wyu0725/2MSPS-DAQ_CARD/README.md

# 2MSPS-DAQ_CARD   
Junbin Zhang and Yu Wang's project----2channel 2MSPS DQA CARD workspace  
datasheet,use of chips,verilog code 
ustc-fel
