wyu0725/2MSPS-DAQ_CARD/Notes/EP4CE10_FIFO使用说明.docx

FIFO

可配置大小

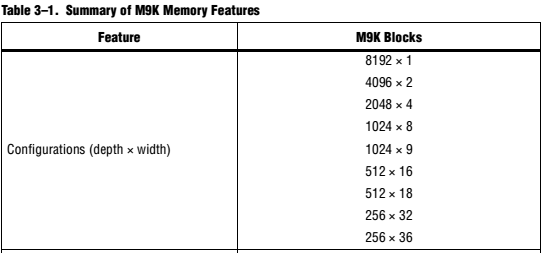
[picture p16: figure]

Cyclone IV devices M9K memory blocks do not support simultaneous read and write from an empty FIFO buffer.

SCFIFO and DCFIFO Functional Timing Requirements

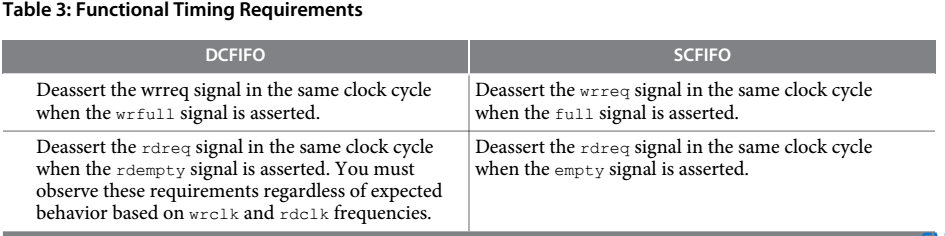
[picture p17: figure]
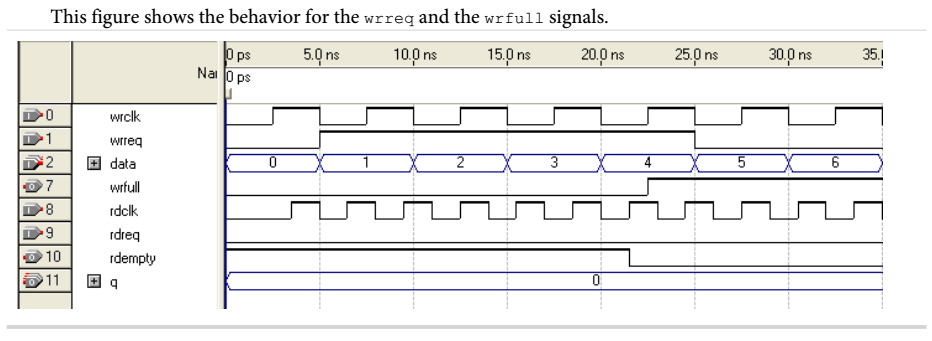
[picture p18: figure]
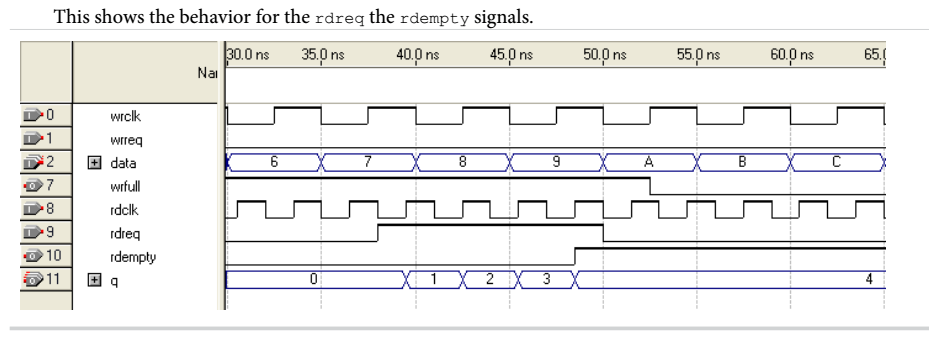
[picture p19: figure]
