wyu0725/2MSPS-DAQ_CARD/Notes/EP4CE10CLOCK&CLB&PLL.docx

CLOCK INFORMATION

EP4CE10 devices only support three dedicated clock pins on the left side and four dedicated clock pins on the right side of the device.

GCLK

1. All resources in the device (I/O elements, logic array blocks (LABs), dedicated multiplier blocks and M9K memory blocks) can use GCLKs as clock sources. Use these clock network resources for control signals, such as clock enables and clears fed by an external pin.
2. Internal logic can also drive GCLKs for internally generated GCLKs and asynchronous clears, clock enables, or other control signals with high fan-out.(?)

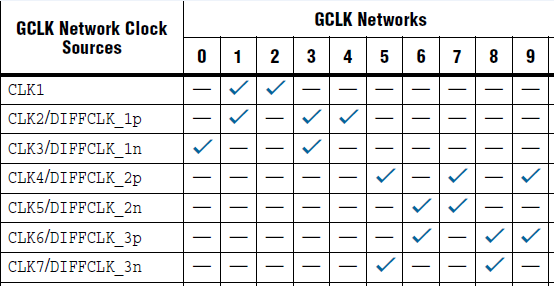
[picture p20: figure]
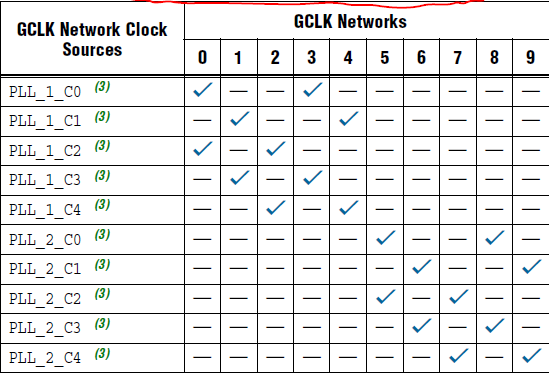
[picture p21: figure]
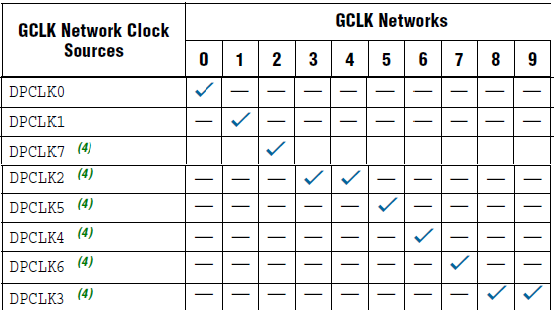
[picture p22: figure]

3. If you do not use dedicated clock pins to feed the GCLKs, you can use them as general-purpose input pins to feed the logic array. However, when using them as general-purpose input pins, they do not have support for an I/O register and must use LE-based registers in place of an I/O register.

CLOCK CONTROL BLOCK

1. The clock control block drives the GCLKs. Clock control blocks are located on each side of the device, close to the dedicated clock input pins. GCLKs are optimized for minimum clock skew and delay.
2. The sources that can feed back the clock control block

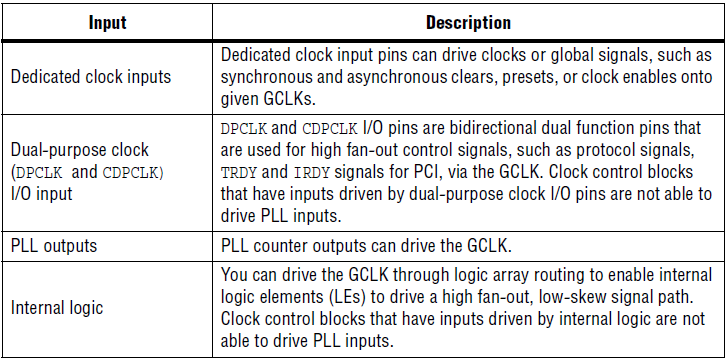
[picture p23: figure]

The output from the clock control block in turn feeds the corresponding GCLK. The GCLK can drive the PLL input if the clock control block inputs are outputs of another PLL or dedicated clock input pins.

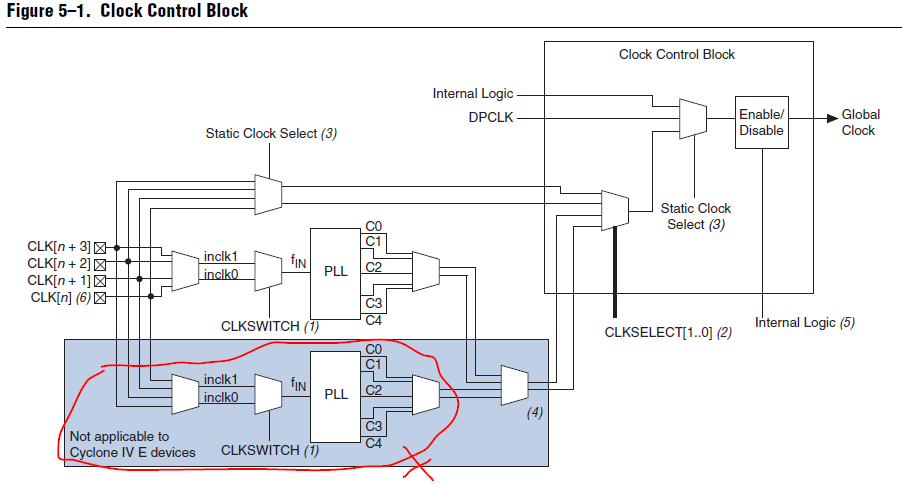
[picture p24: figure]

3. Clock Networks and Clock Control Block Locations in Cyclone IV E Devices

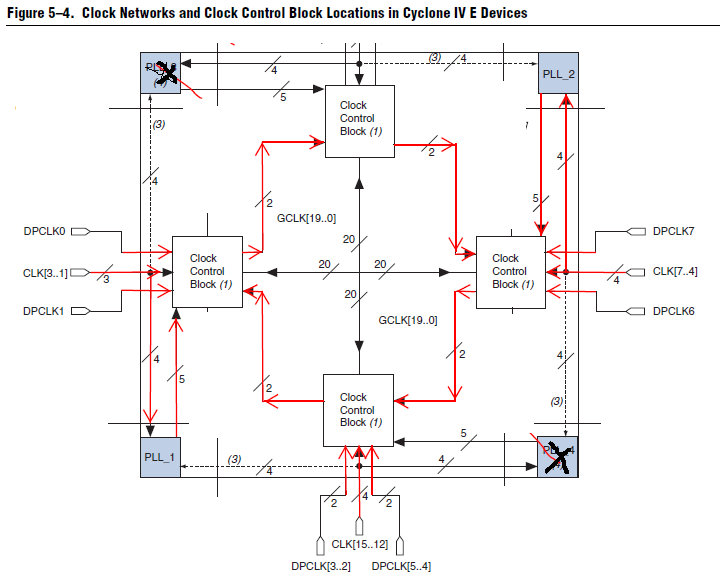
[picture p25: figure]

4. The inputs to the five clock control blocks on each side of the Cyclone IV E device must be chosen from among the following clock sources:
- Three or four clock input pins, depending on the specific device
- Five PLL counter outputs
- Two DPCLK pins and two CDPCLK pins from both the left and right sides and four DPCLK pins from both the top and bottom
- Five signals from internal logic

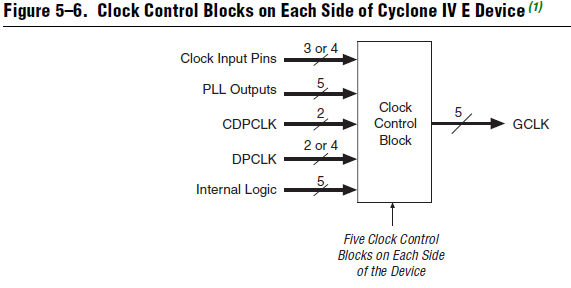
[picture p26: figure]

Clock control block user guides

Note: The IP Catalog (Tools > IP Catalog) and parameter editor replace the MegaWizard™ Plug-In Manager for IP selection and parameterization, beginning in Quartus II software version 14.0.

A. MegaWizard Parameter Settings
1. In the IP Catalog (Tools > IP Catalog), locate and double-click the name of the IP core to customize. The parameter editor appears.
2. Specify a top-level name for your custom IP variation. The parameter editor saves the IP variation settings in a file named <your_ip>.qsys. Click OK.
3. Specify the parameters and options for your IP variation in the parameter editor, including one or more of the following. Refer to your IP core user guide for information about specific IP core parameters.
4. Click Generate HDL, the Generation dialog box appears. Specify output file generation options, and then click Generate. The IP variation files generate according to your specifications.
5. Specify output file generation options, and then click Generate. The IP variation files generate according to your specifications.
6. To generate a simulation testbench, click Generate > Generate Testbench System.
7. To generate an HDL instantiation template that you can copy and paste into your text editor, click Generate > HDL Example.
8. Click Finish. The parameter editor adds the top-level .qsys file to the current project automatically. If you are prompted to manually add the .qsys file to the project, click Project > Add/Remove Files in Project to add the file.
9. After generating and instantiating your IP variation, make appropriate pin assignments to connect ports.

PLLs in Cyclone IV Devices

Cyclone IV E devices only have the general purpose PLLs. It can be used for general-purpose applications in the FPGA

fabric and periphery such as external memory interfaces. Note:The general I/O pins cannot drive the PLL clock input pins.

1. The features available in Cyclone IV E PLLs

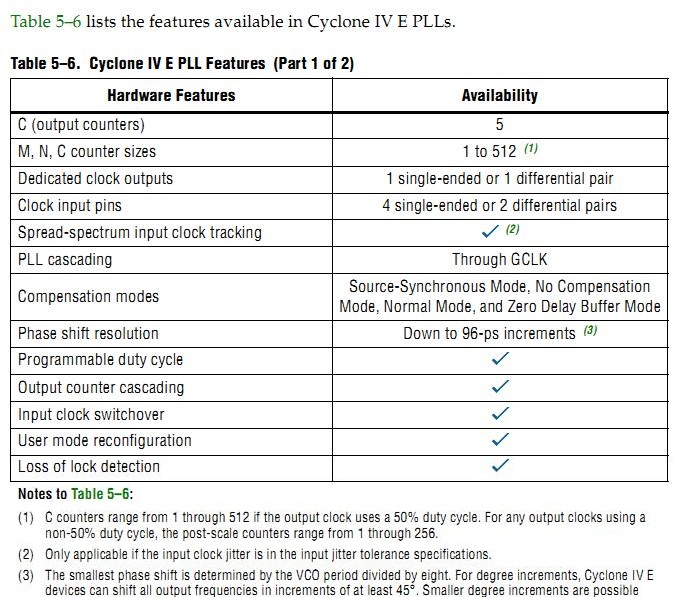
[picture p27: figure]

Output counters 是什么不太清楚，从下面的框图理解应该是不同分频频率的计数。

2. PLL Block Diagram

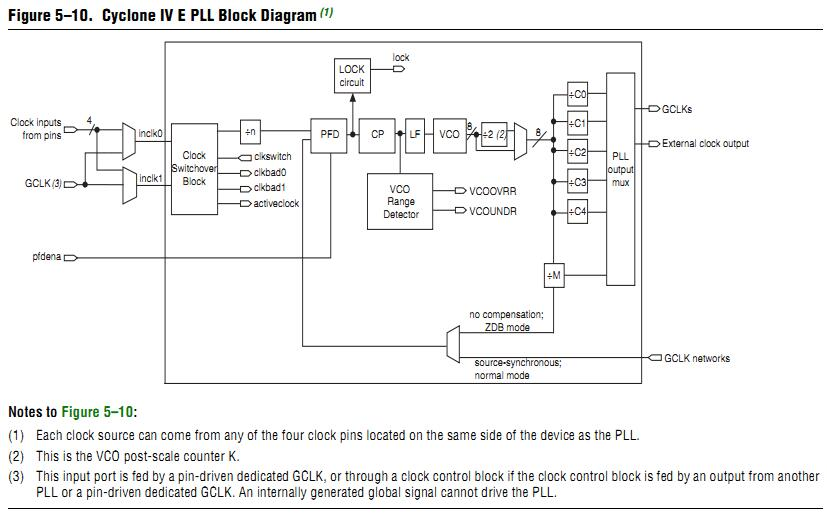
[picture p28: figure]

3. External Clock Outputs

Each PLL of Cyclone IV devices supports one single-ended clock output or one differential clock output. Only the C0 output counter can feed the dedicated external clock outputs, as shown in Figure 5–11, without going through the GCLK. Other output counters can feed other I/O pins through the GCLK. Cyclone IV PLLs can drive out to any regular I/O pin through the GCLK.（也就是说PLL的时钟输出可以通过GCLK输出到普通I/O管脚上。我理解的是通过PLL驱动GCLK，然后由GCLK输出给普通I/O.）

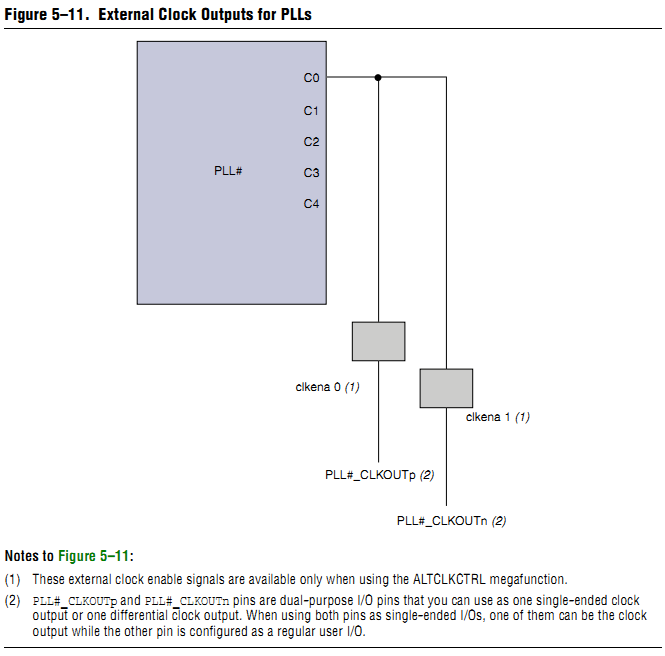
[picture p29: figure]
