wyu0725/2MSPS-DAQ_CARD/Cyclone IV user guides/pll feed back mode&hardware features.pdf

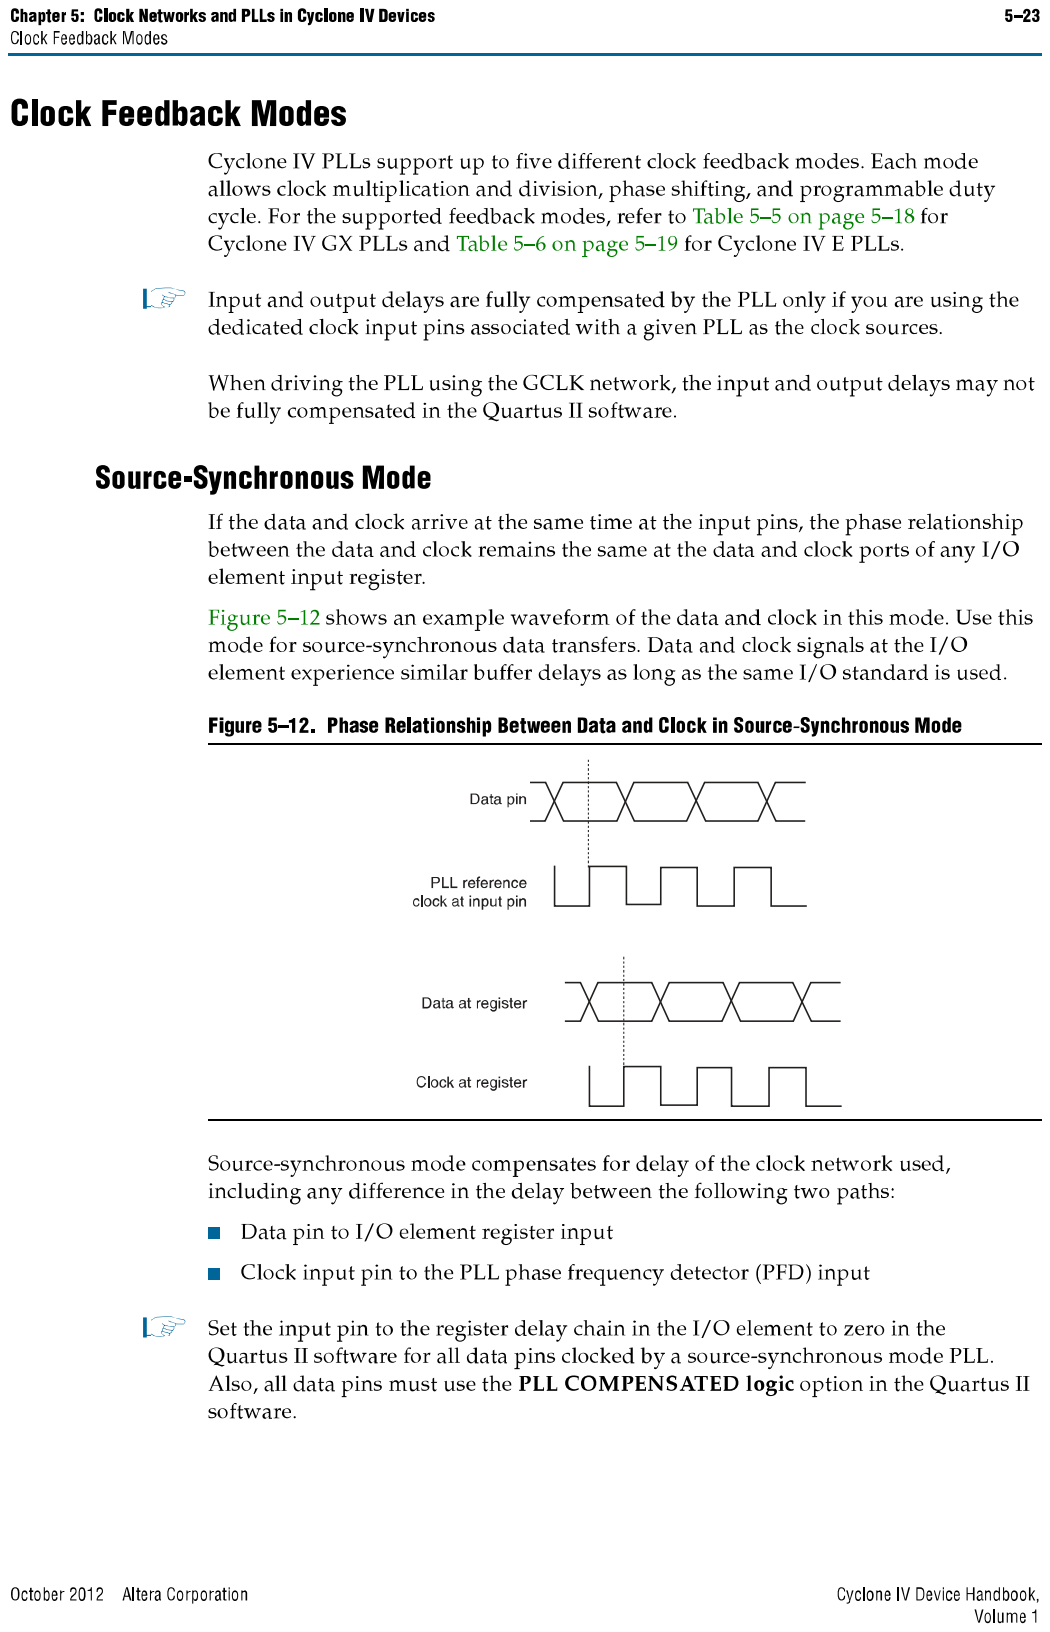
[picture p41: page 1]

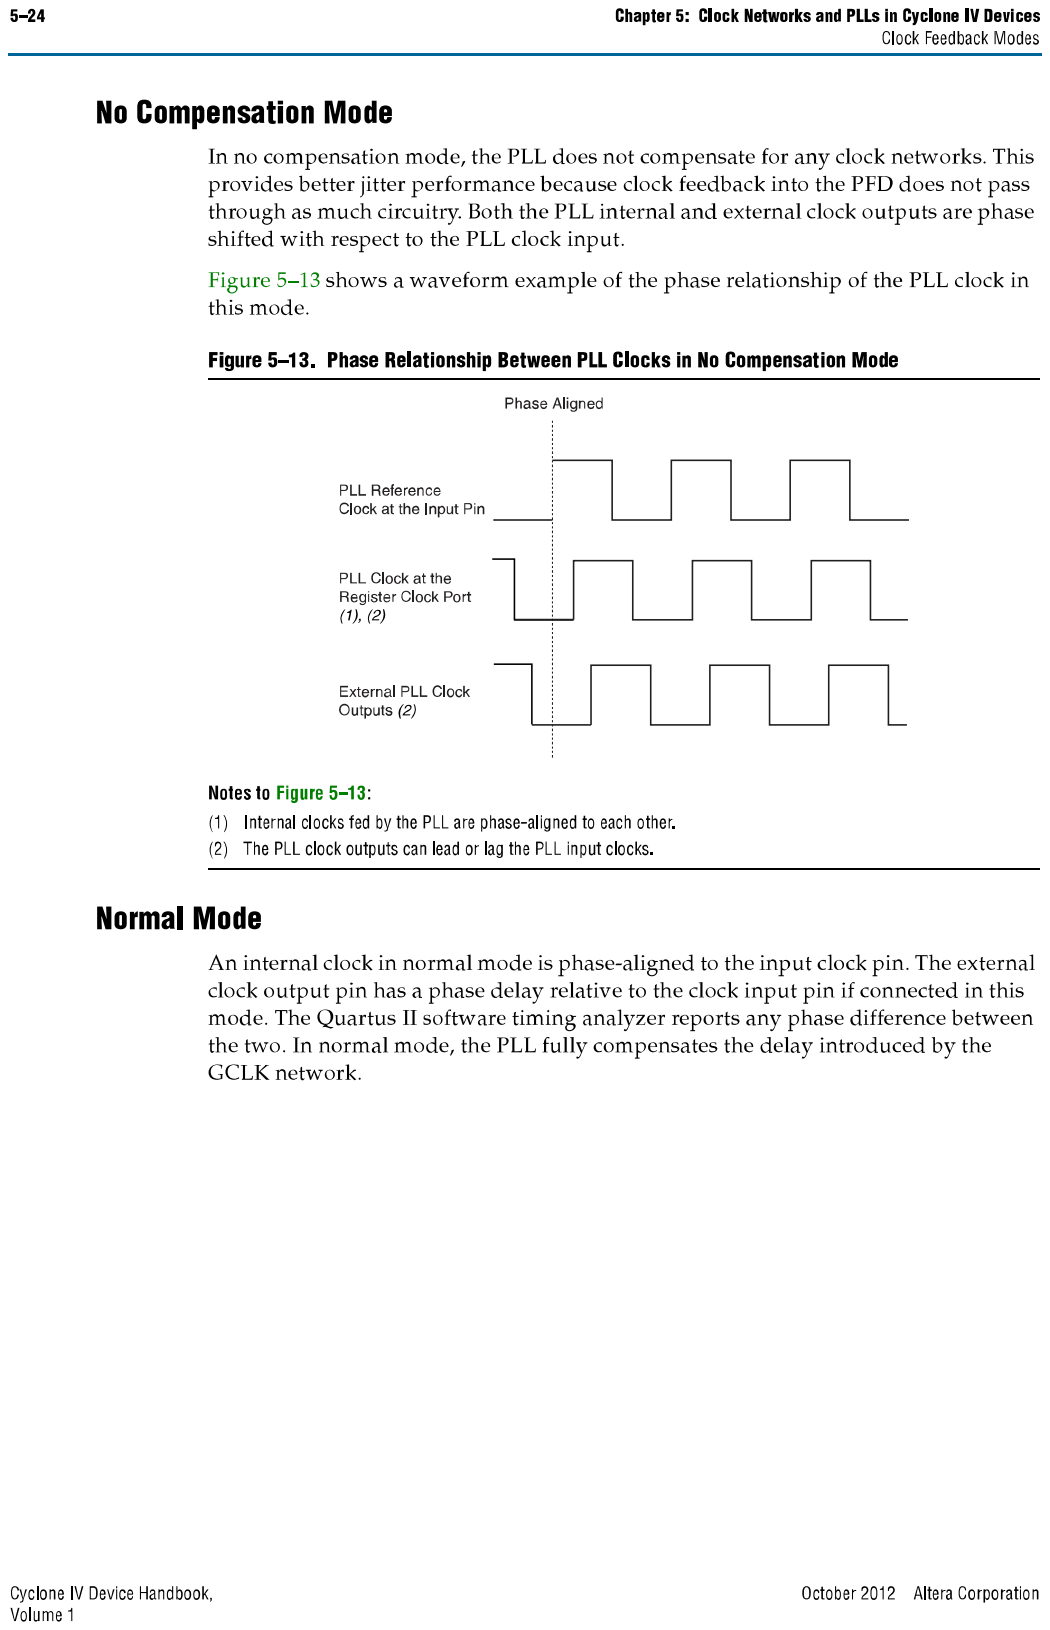
[picture p42: page 2]

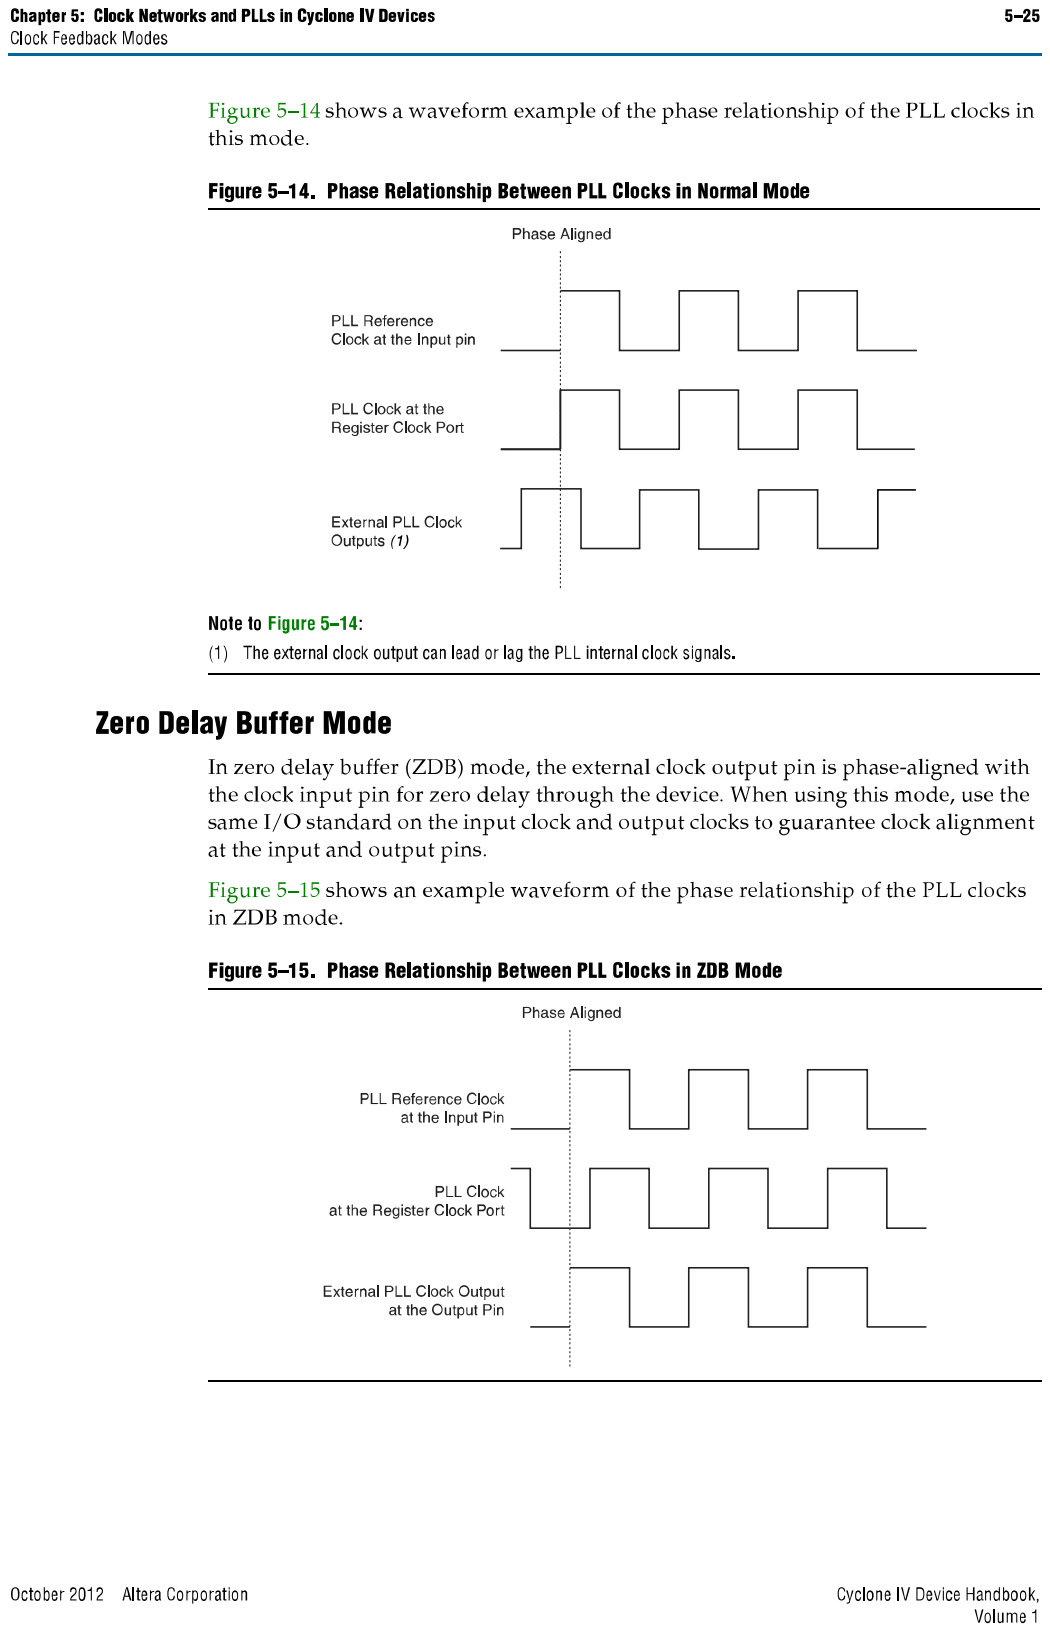
[picture p43: page 3]

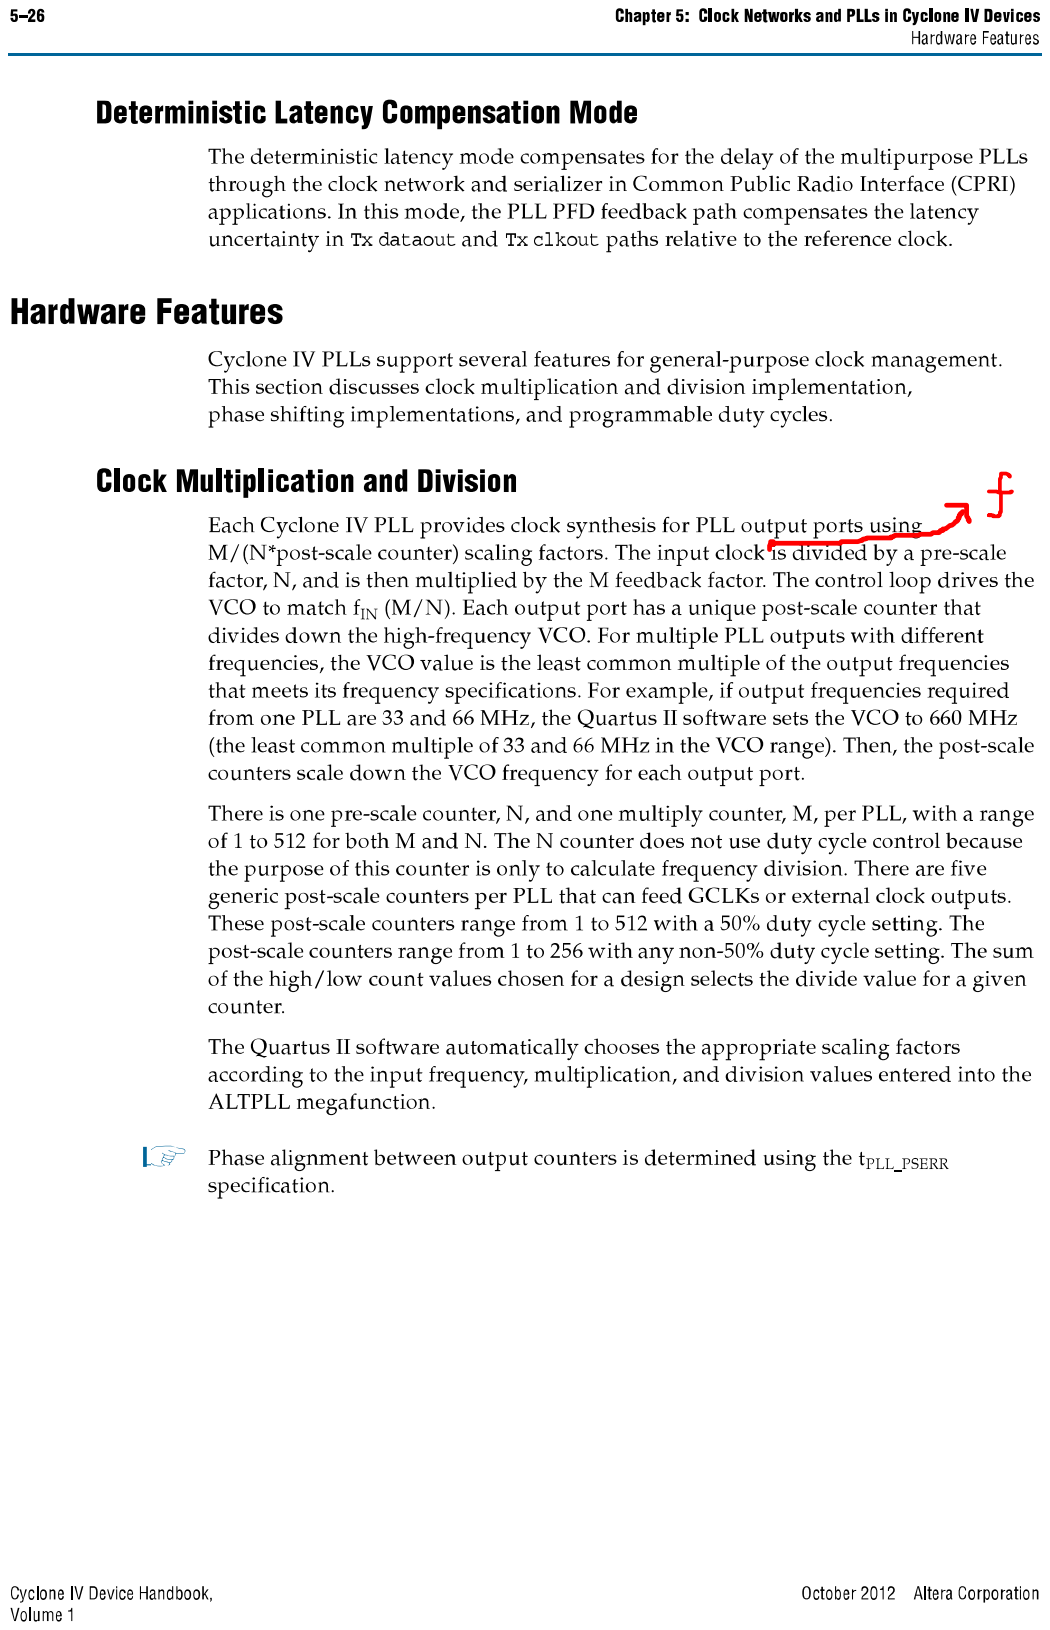
[picture p44: page 4]

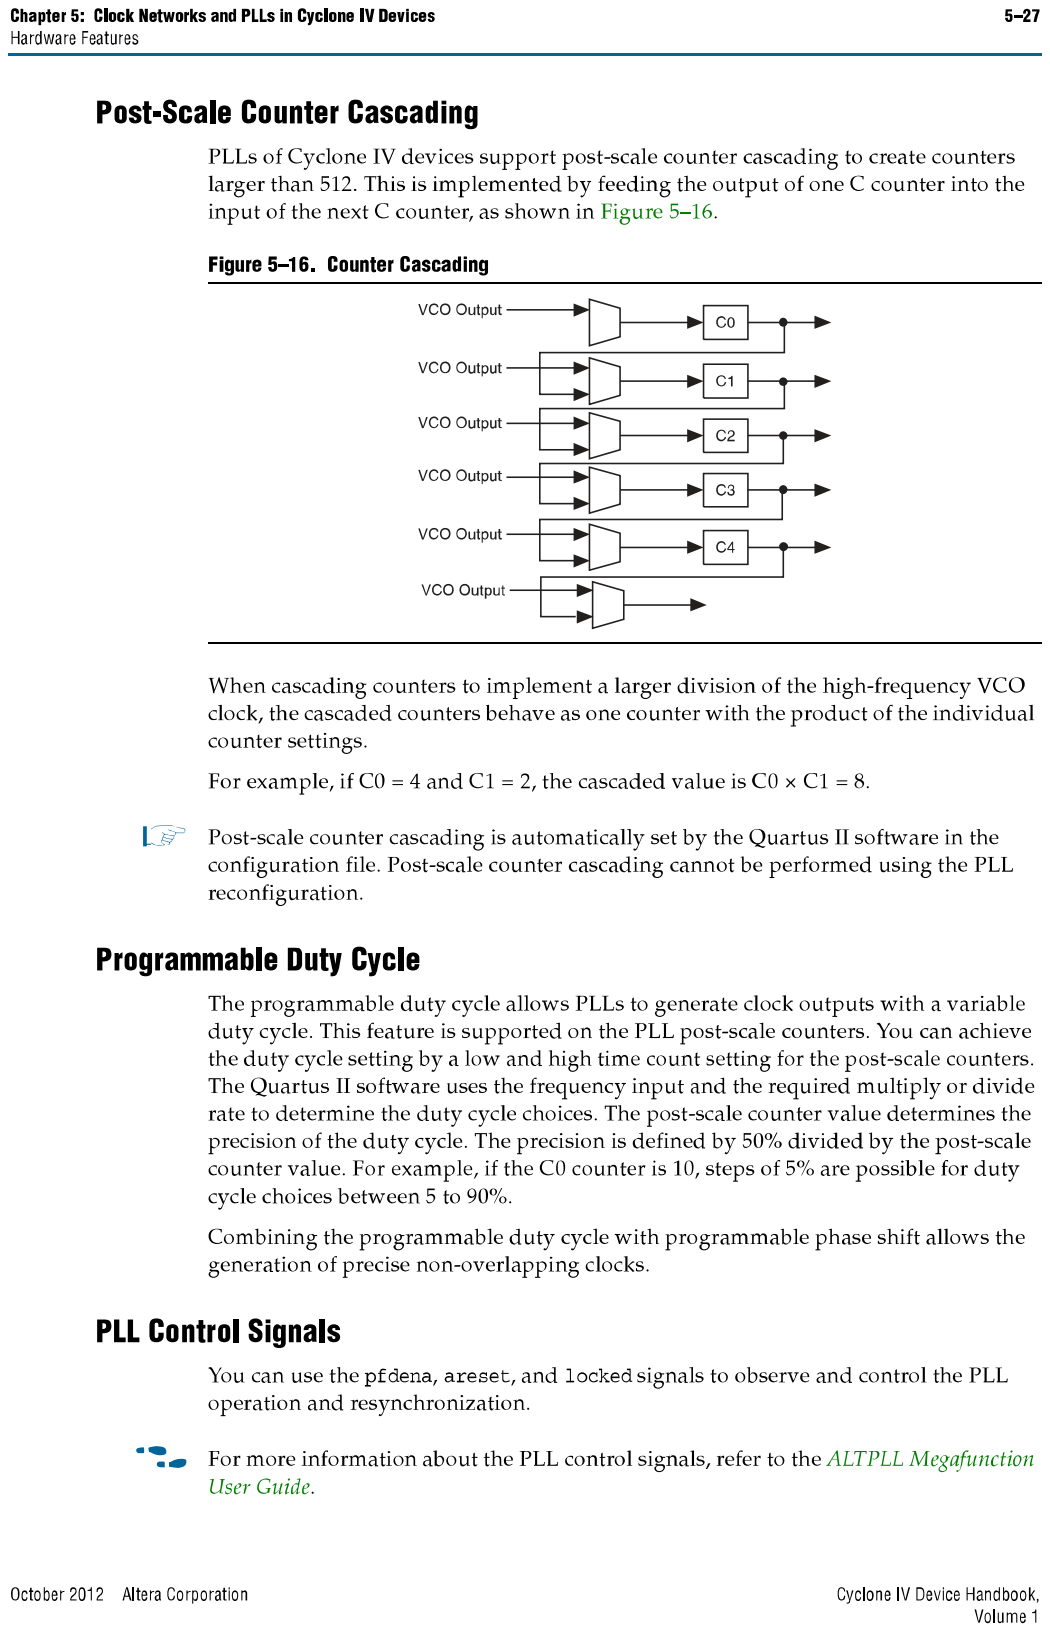
[picture p45: page 5]
