wyu0725/2MSPS-DAQ_CARD/RTL/ADC_AD7985_Control/ADC_AD7985_Control_wave2.pdf

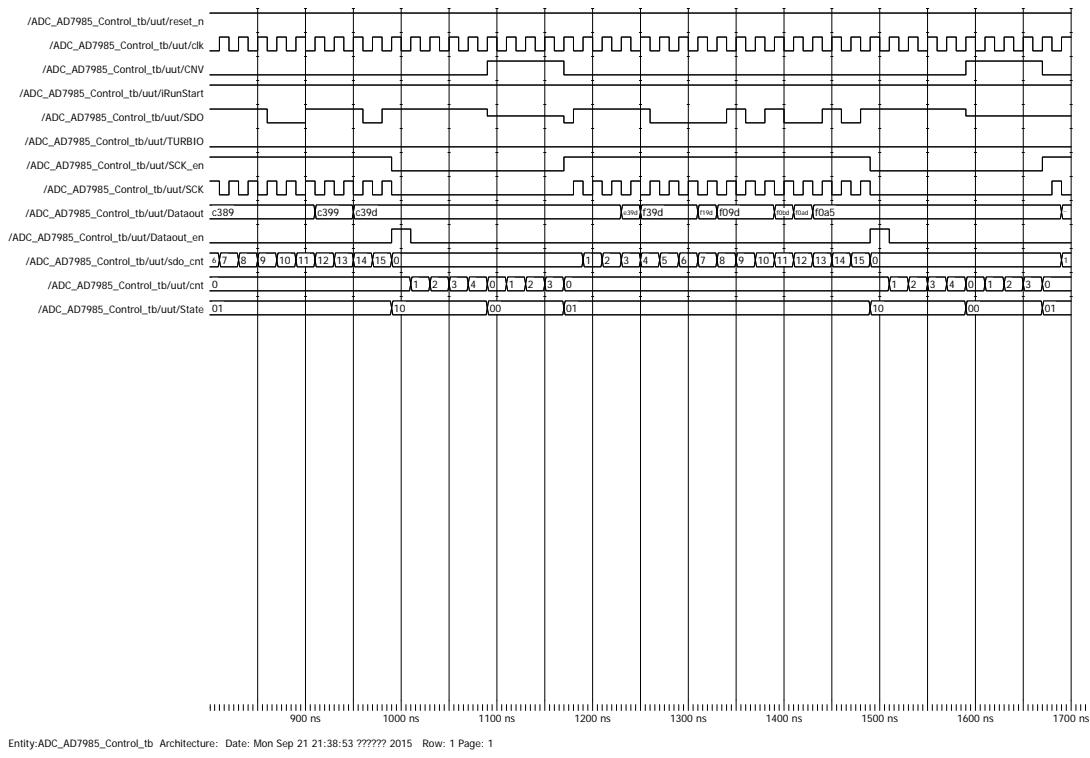
[picture p47: page 1]
/ADC_AD7985_Control_tb/uut/reset_n; /ADC_AD7985_Control_tb/uut/clk; /ADC_AD7985_Control_tb/uut/CNV; /ADC_AD7985_Control_tb/uut/iRunStart; /ADC_AD7985_Control_tb/uut/SDO; /ADC_AD7985_Control_tb/uut/TURBIO; /ADC_AD7985_Control_tb/uut/SCK_en; /ADC_AD7985_Control_tb/uut/SCK; /ADC_AD7985_Control_tb/uut/Dataout c389; /ADC_AD7985_Control_tb/uut/Dataout_en; /ADC_AD7985_Control_tb/uut/sdo_cnt 6 7 8; /ADC_AD7985_Control_tb/uut/cnt 0; /ADC_AD7985_Control_tb/uut/State 01

Entity:ADC_AD7985_Control_tb Architecture: Date: Mon Sep 21 21:38:53 ?????? 2015 Row: 1 Page: 1
