wyu0725/2MSPS-DAQ_CARD/(list of files, drawings)

Other design files:
cadence/capture/DAQ_CARD_2V0.DSN
