wyu0725/2MSPS-DAQ_CARD/(commit log)

2015-09-17 ADC readout clock
    AD7985采样、转换和读数的时钟
2015-09-17 管脚分配文件
    保留了ADC、USB、JTAG,AS配置管脚
    时钟输入、TRG_IN，TRG_OUT、LED[6:1]
    !!SCK2的连接有问题，从LED中找一个
2015-09-17 差分转单端运放
2015-09-17 差分驱动
2015-09-17 芯片采购清单
2015-09-17 电源芯片
2015-09-17 ADC readout clock
    AD7985采样转换读数时钟
    ADD:改正读数的一个模式
2015-09-19 ppt//还没写完
2015-09-20 ADC读数时钟
    添加了一种读数模式
2015-09-20 2MSPS DAQ_CARD
    待修改
2015-09-20 QuartusII批量分配管脚方法
2015-09-21 读数时序
2015-09-21 ADC_Control
    ADC Control signal
    modelsim wave
2015-09-21 ADC Control
2015-09-22 FIFO使用说明
2015-09-22 ADC读数时序
2015-09-30 20150930修改
    [DAQ_CARD.brd]
